ian-ross/pump-monitor/README.md

# pump-monitor
IoT system for pump shaft monitoring
