ian-ross/pump-monitor/doc/requirements.odt

Pump Monitor Requirements

# Components

## Enclosure

- Plastic sandwich box with locking cover
- Standard cable passthroughs with screw clamp and soft collet
- Silica gel dessicant
- Secure to pipe in shaft with jubilee clip, boltholes sealed with silicone gel

## Mains power input

- Short (30cm?) cable with mains plug to cable passthrough into enclosure.

## Power splitter

- Mains power input cable taken to standard junction box.

## Pump power outlet

- Water-resistant mains socket let into hole in enclosure, hole sealed with silicone gel.

## Pump power sensing

- Rogowski sense coil (Pulse PA3208NL) mounted inside junction box enclosing only live wire of connection to pump power.
- Pump power is 400 W, so 1.7 A RMS current when it’s on. The PA3208NL outputs 383 μV/A for 50 Hz input, i.e. about 650 μV.
- The Rogowski coil needs a data acquisition chip to go with it. Options are:
  - Analog Devices ADE7753 (€3.73, SPI interface, SSOP-20). Use this one, just because it has simpler interfacing – the ST Micro device has a very strange non-SPI serial interface.
  - ST Micro STPM01FTR (€2.40, weird non-SPI interface, TSSOP-20, has mode for current-only measurements).
- Another option is to implement a simple integrator and front-end amplifier with op-amps, then to use an ADC with an SPI interface (for the RPi) to sample the current signal.
- Question: what is the simplest way to do this? Using a dedicated di/dt current sense processing chip seems like the best idea, so go with the ADE7753.

## DC power supply

- Mains socket secured inside enclosure.
- Extension cable cut to give socket for this part and plug for 1.2.
- Encapsulated switching power supply plugged into socket.
- RPi power supply, and take 5V supply for other components from RPi headers.

## Processing

- Raspberry Pi 4.

## Ultrasonic sensor

- Something like one of the sensors from DFRobot.
- 5V supply.

## Pump control

- Pin the float switch of the pump on and use an SSR to start and stop the pump, i.e. control the pump directly from the monitor controller.
- Because the level monitoring needs to work correctly for the SSR approach to work, write software to run in two modes: “float mode” has the SSR permanently on, and uses the float switch on the pump to switch the pump on and off; “SSR mode” pins the float switch on and uses the SSR to switch the pump on and off, based on the water level measurements. For calibration of the level measurements for the SSR mode, the system can be run in float mode for a couple of months to collect data about water levels and when the pump switches on and off. That data can then be used to set up a control law for the SSR mode.

# Development steps

1. Test Wi-Fi transmission from within shaft (Arduino board in plastic box powered from USB supply threaded through hole in shaft cover). Done: doesn’t work, so use powerline network adapters. That means using something other than an Arduino: a Raspberry Pi has an Ethernet connection, so use the RPi 4 I have.
2. Breadboard pump power sense coil setup. (Even if you don’t use it, this is an interesting thing to do.) Done: couldn’t get it to work. Need to use a proper sense coil instead (a Rogowski coil, and associated circuitry).
3. Design carrier board:
  - power distribution;
  - connection to ultrasonic sensor;
  - power sense coil circuitry;
  - outputs suitable for driving an SSR.
4. Server software.
5. Initial installation: enclosure, power distribution, ultrasonic sensor, pump power sense coil, RPi, carrier board.
6. Actuator/pump control development (and if needed carrier board rev 2 or separate solenoid driver board).

# Software

## Arduino software

- Sample depth from ultrasonic sensor on regular timestep (1 Hz, statistics over 1 minute?)
- Current sense for pump supply on regular timestep (1 Hz, statistics over 1 minute?)
- Upload results to server on regular timestep (1 per minute?)

## Server software

- POST route for Arduino data upload (JSON with water depth and pump supply statistics and “twitched” flag)
- Pages to view saved data
- Alerts?
