ian-ross/pump-monitor/doc/box-layout.png

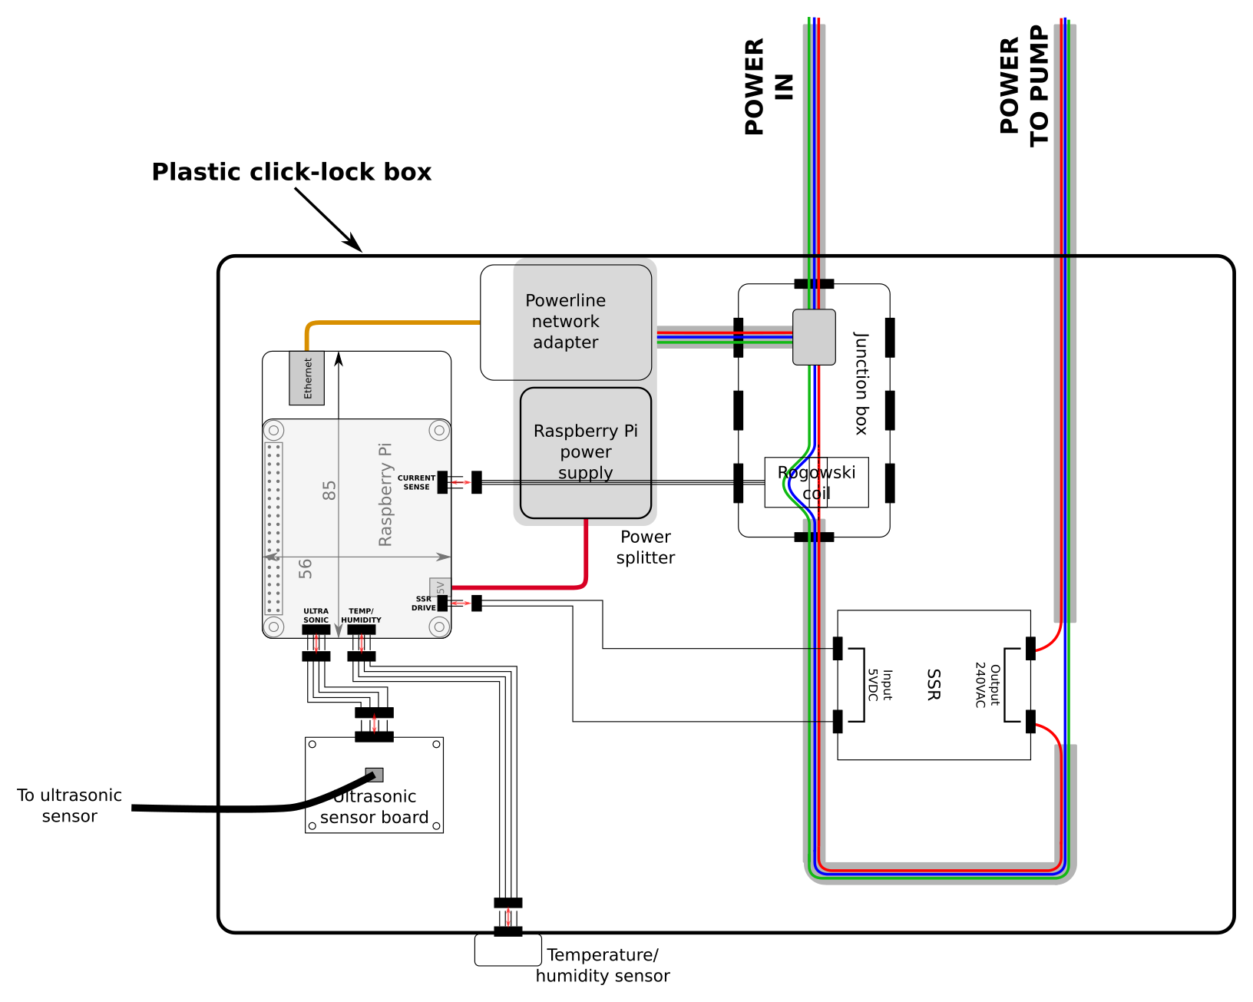
doc/box-layout.png
