ian-ross/pump-monitor/doc/system-diagram.png

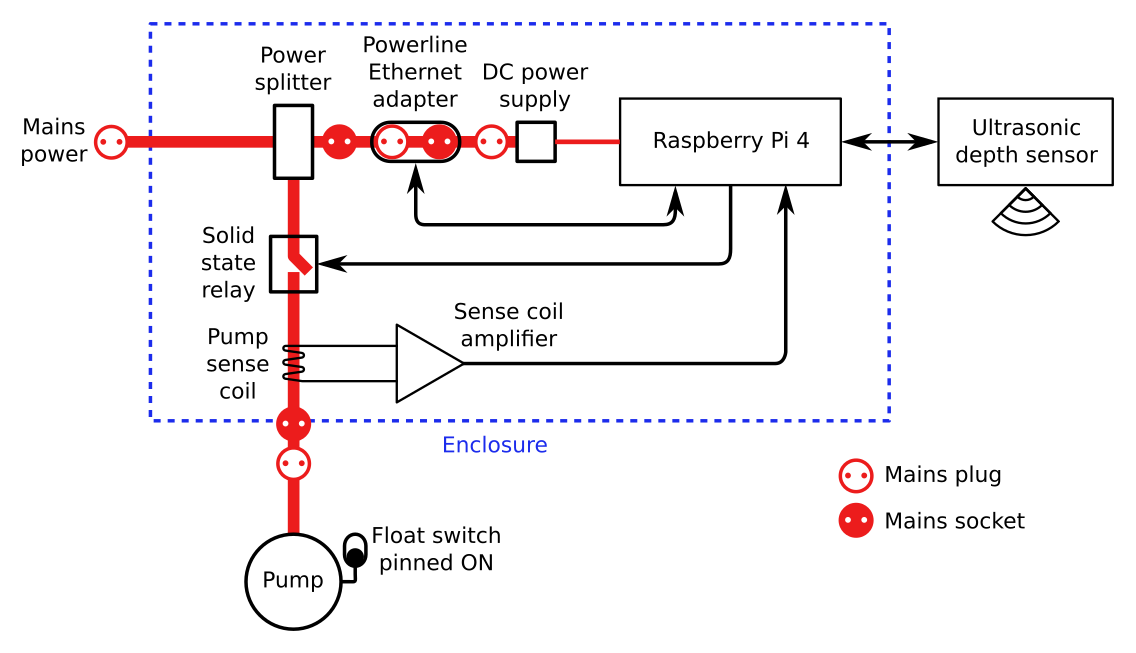
doc/system-diagram.png
