ian-ross/pump-monitor/pump-monitor-interface-board/pump-monitor-interface-board-bom.ods

Reference | Quantity | Value | MPN | In stock | Footprint | Datasheet | Link
J2 | 1 | RPI_HAT | SSQ-120-01-L-D | N | Connector_PinSocket_2.54mm:PinSocket_2x20_P2.54mm_Vertical | https://www.mouser.at/datasheet/2/527/ssq_th-1370157.pdf
J1 J3 | 2 | Conn_01x04 | TSW-104-25-T-S-RA | N | Connector_PinHeader_2.54mm:PinHeader_1x04_P2.54mm_Horizontal | https://www.mouser.at/datasheet/2/527/tsw_th-1345997.pdf
J4 | 1 | Conn_01x02 | TSW-102-25-T-S-RA | N | Connector_PinHeader_2.54mm:PinHeader_1x02_P2.54mm_Horizontal | https://www.mouser.at/datasheet/2/527/tsw_th-1345997.pdf
J5 | 1 | Conn_01x03 | TSW-103-25-F-S-RA | N | Connector_PinHeader_2.54mm:PinHeader_1x03_P2.54mm_Horizontal | https://www.mouser.at/datasheet/2/527/tsw_th-1345997.pdf
Q1 | 1 | 2N7002 | 2N7002ET7G | N | Package_TO_SOT_SMD:SOT-23 | https://www.mouser.at/datasheet/2/308/2N7002E_D-1571276.pdf | https://www.mouser.at/ProductDetail/ON-Semiconductor/2N7002ET7G?qs=l7cgNqFNU1iSXTOSQi2ecw%3D%3D
R11 | 1 | 6.8K | CRCW08056K80FKEA | N | Resistor_SMD:R_0805_2012Metric_Pad1.20x1.40mm_HandSolder | ~
R15 | 1 | 47K | CRCW080547K0FKEAC | N | Resistor_SMD:R_0805_2012Metric_Pad1.20x1.40mm_HandSolder | ~
R16 | 1 | 68K | CRCW080568K0FKEA | N | Resistor_SMD:R_0805_2012Metric_Pad1.20x1.40mm_HandSolder | ~
R20 R21 | 2 | 100K | CRCW0805100KFKEAC | N | Resistor_SMD:R_0805_2012Metric_Pad1.20x1.40mm_HandSolder | ~
R6 | 1 | 5K | CRCW08055K00FKTA | N | Resistor_SMD:R_0805_2012Metric_Pad1.20x1.40mm_HandSolder | ~
U3 | 1 | LMV321 | LMV321AIDBVR | N | Package_TO_SOT_SMD:SOT-23-5_HandSoldering | https://www.ti.com/lit/ds/symlink/lmv321a.pdf | https://www.ti.com/product/LMV321A
C1 C3 C6 | 3 | 1U | 885012107015 | Y | Capacitor_SMD:C_0805_2012Metric_Pad1.18x1.45mm_HandSolder
C2 C4 C5 C7 | 4 | 0.1U | 885012207098 | Y | Capacitor_SMD:C_0805_2012Metric_Pad1.18x1.45mm_HandSolder
D1 D2 | 2 | 1N914 | 1N914BW RH | Y | Diode_SMD:D_SOD-123F | https://www.mouser.at/datasheet/2/395/1N4148W_SERIES_K1804-1519318.pdf
R1 R13 | 2 | 12K | CRCW080512K0FKEA | Y | Resistor_SMD:R_0805_2012Metric_Pad1.20x1.40mm_HandSolder | ~
R4 R5 R8 R10 R12 | 5 | 10K | CRGP0805F10K | Y | Resistor_SMD:R_0805_2012Metric_Pad1.20x1.40mm_HandSolder | ~
R2 R14 R17 | 3 | 22K | CRCW080522K0FKEAC | Y | Resistor_SMD:R_0805_2012Metric_Pad1.20x1.40mm_HandSolder | ~
R3 R18 R19 | 3 | 1K | CRGP0805F1K0 | Y | Resistor_SMD:R_0805_2012Metric_Pad1.20x1.40mm_HandSolder | ~
R7 | 1 | 330K | CRCW0805330KFKEA | Y | Resistor_SMD:R_0805_2012Metric_Pad1.20x1.40mm_HandSolder | ~
R9 | 1 | 18K | CRGP0805F18K | Y | Resistor_SMD:R_0805_2012Metric_Pad1.20x1.40mm_HandSolder | ~
U1 | 1 | TLV4333 | TLV4333IDR | Y | Package_SO:SO-14_3.9x8.65mm_P1.27mm | https://www.ti.com/lit/ds/symlink/tlv4333.pdf | https://www.ti.com/product/TLV4333
U2 | 1 | LMV331 | LMV331IDBVR | Y | Package_TO_SOT_SMD:SOT-23-5_HandSoldering | http://www.ti.com/lit/ds/symlink/lmv331.pdf | https://www.ti.com/product/LMV331
