ian-ross/pump-monitor/doc/bom.ods

Component | Source | Part # | Qty | Description
Enclosure |  |  | 1 | Locking plastic box (size?)
Mains extension cable | Obi | 1831197 | 1 | 5m extension cable to cut for power input, socket for DC power supply, and cable from junction box to pump socket
Mains junction box | Obi | 8025538 | 1 | 40 mm x 56 mm x 23 mm, 4 connections
Waterproof mains socket | Obi | 7203417 | 1 | IP44 mains socket
Mains cable clamps | Obi |  | 3 | Standard 3-hole cable clamps
Cable passthroughs | Obi | 6057178 | 3? | 4.5-10 mm wire diameter
DC power supply |  |  | 1 | Raspberry Pi power supply
Raspberry Pi 4 |  |  | 1
Ultrasonic sensor | DFRobot? | SEN0313 | 1 | A01NYUB waterproof sensor (screw mounting)
Pump sense coil | n/a | n/a | 1-3 | Make from jumper wire, silicone gel and heat shrink tubing | <=== DOESN’T WORK. NEED TO RESEARCH.
Pump sense coil amplifier |  |  | 1-3
(Solid-state?) relay | Mouser |  | 1
Powerline Ethernet adapter | mylemon.at | TL-PA4010PKIT | 2 | TP-Link AV500+ Powerline Kit
