ian-ross/pump-monitor/pump-monitor-interface-board/pump-monitor-interface-board-schematic.pdf

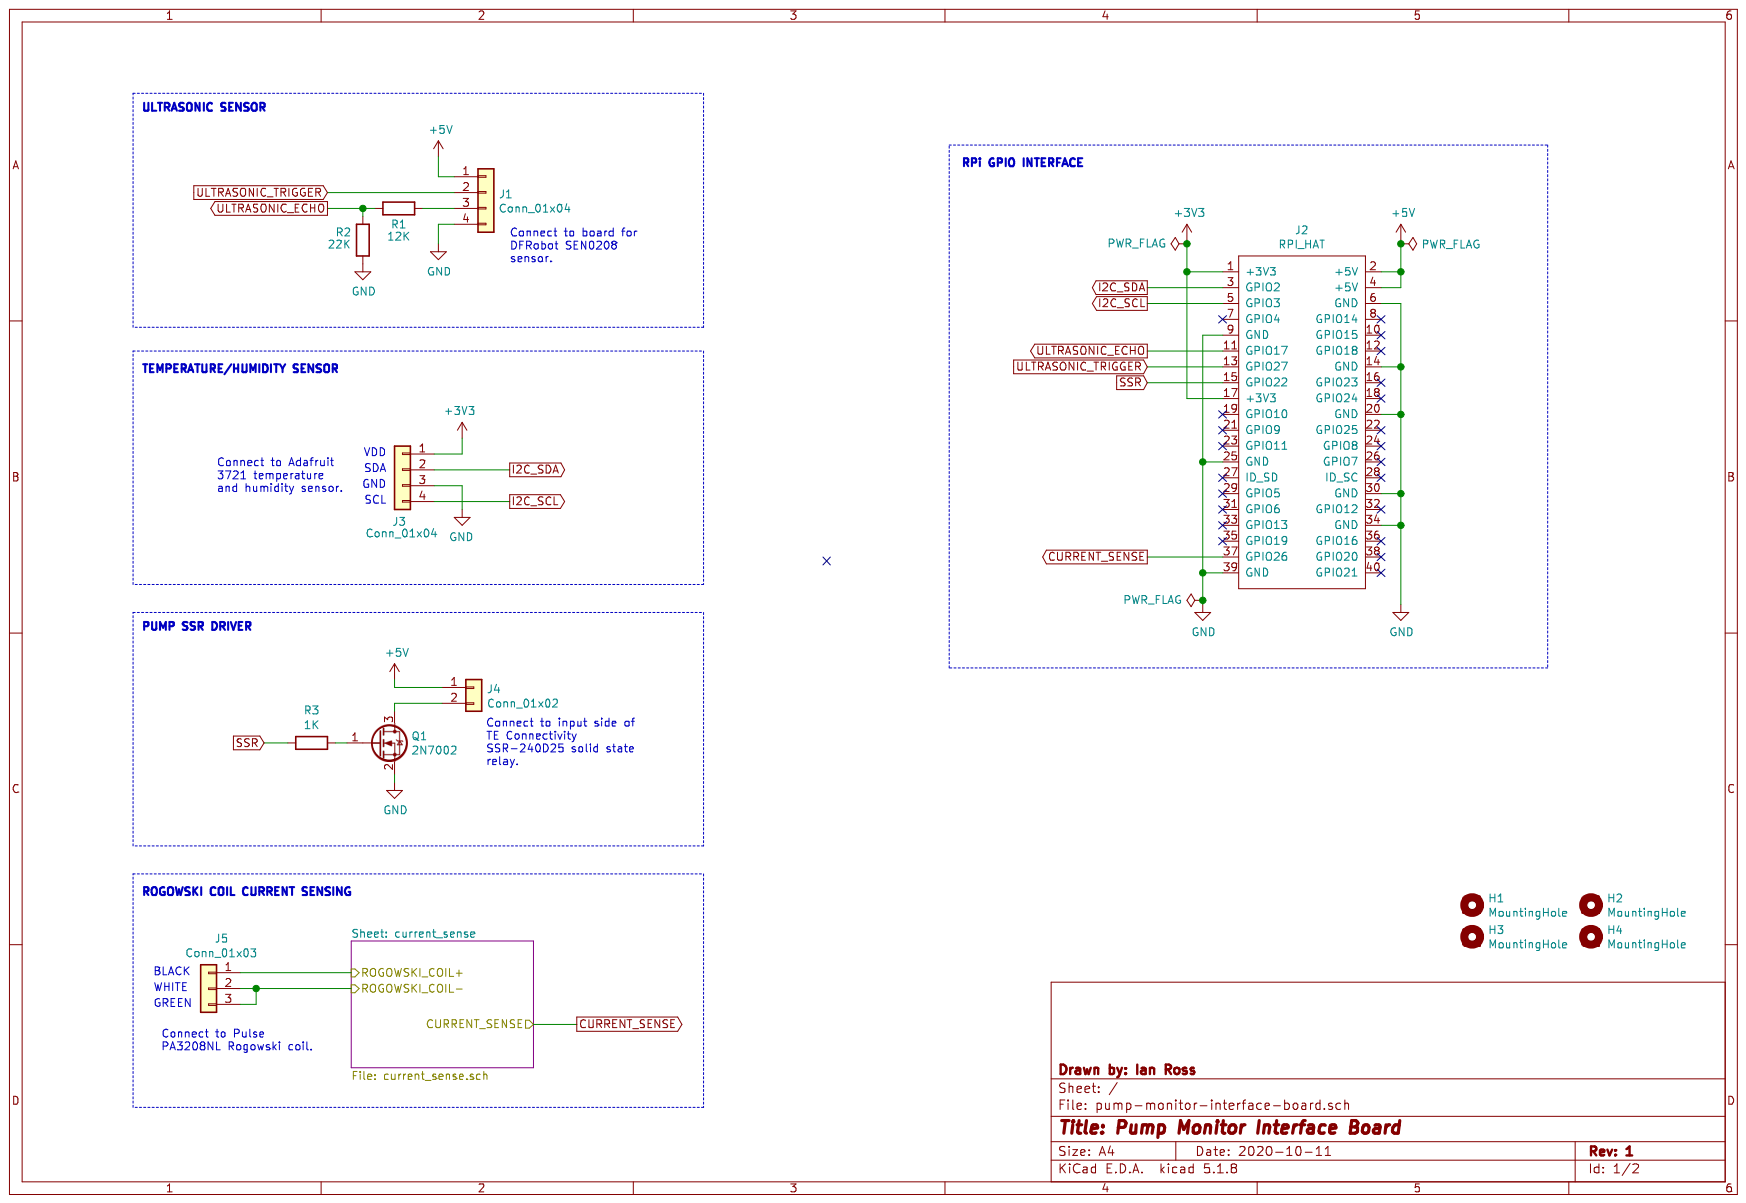
[picture p3: page 1]

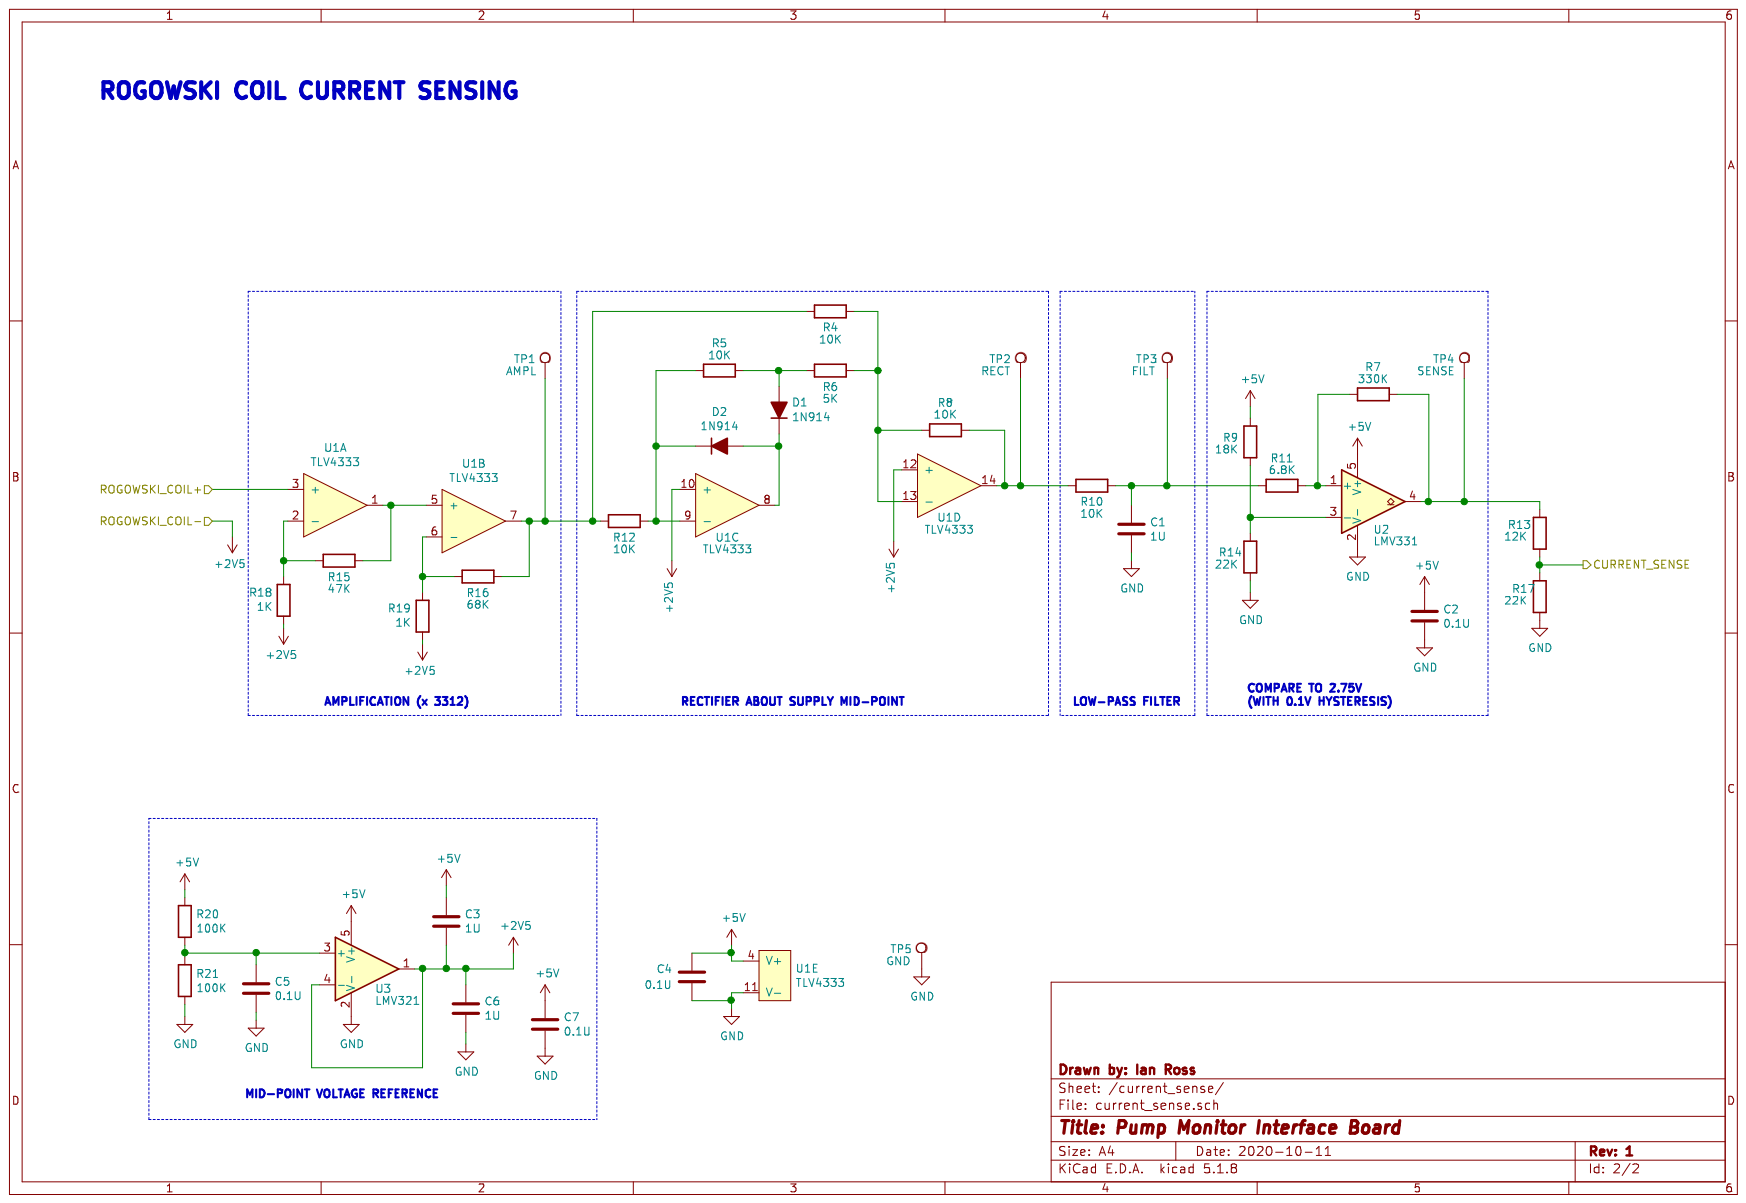
[picture p4: page 2]
