ian-ross/pump-monitor/experiments/rogowski-coil/rogowski-coil-1.asc

R1: res; 1K
R2: res; 50K
R3: res; 1K
R4: res; 50K
Rload: res; 10Meg
U3: AD8539
U4: AD8539
V1: voltage; 2.5
V2: voltage; -2.5
Vin: voltage; SINE(0 0.6M 50 1 0 0 250)
Named nets: +V, 0, OUT, IN, -V
.tran 0 10 0
