ian-ross/pump-monitor/experiments/rogowski-coil/rogowski-coil-2.asc

C1: cap; 0.1µ
C2: cap; 1µ
C3: cap; 1µ
C4: cap; 1µ
R1: res; 1K
R2: res; 50K
R3: res; 1K
R4: res; 50K
R5: res; 100K
R6: res; 100K
R7: res; 2K
R8: res; 3K
Rload: res; 100K
U1: AD8538
U2: LT1720
U3: AD8539
U4: AD8539
V3: voltage; 5
Vin: voltage; SINE(0 0.6M 50 0.1 0 0 100)
Named nets: OUT, IN, +V, 0, Vmid
.tran 0 2.5 0
