ian-ross/pump-monitor/experiments/rogowski-coil/rogowski-coil-3.asc

C1: cap; 0.1µ
C2: cap; 1µ
C3: cap; 1µ
C4: cap; 1µ
D1: diode
D2: diode
R1: res; 1K
R2: res; 47K
R3: res; 1K
R4: res; 68K
R5: res; 100K
R6: res; 100K
R7: res; 18K
R8: res; 22K
R9: res; 10K
R10: res; 10K
R11: res; 5K
R12: res; 10K
R13: res; 10K
R14: res; 10K
R15: res; 6.8K
R16: res; 330K
U1: AD8538
U2: LT1720
U3: AD8539
U4: AD8539
U5: AD8539
U6: AD8539
V3: voltage; 5
Vin: voltage; SINE(0 0.6M 50 0.1 0 0 50)
Named nets: OUT, IN, +V, 0, Vmid
.tran 0 1.5 0
SPLIT SUPPLY
AMPLIFICATION (x 3312)
RECTIFIER ABOUT SUPPLY MID-POINT
COMPARE TO 2.75V
(WITH 0.1V HYSTERESIS)
SOURCE: 600 MICRO-VOLT @ 50 Hz
LOW-PASS FILTER
