ian-ross/pump-monitor/experiments/rogowski-coil/rogowski-coil-5.asc

C1: cap; 0.1µ
C2: cap; 1µ
C3: cap; 1µ
C4: cap; 1µ
D1: schottky; 1N5817
R1: res; 1K
R2: res; 50K
R3: res; 1K
R4: res; 50K
R5: res; 100K
R6: res; 100K
Rload: res; 10K
U1: AD8538
U3: AD8539
U4: AD8539
V3: voltage; 5
Vin: voltage; SINE(0 0.6M 50 0.1 0 0 100)
Named nets: OUT, IN, +V, 0, Vmid
.tran 0 2.5 0
