ian-ross/pump-monitor/experiments/rogowski-coil/rogowski-coil-6.asc

C4: cap; 4.7µ
D1: diode
D2: diode
R1: res; 1K
R2: res; 47K
R3: res; 1K
R4: res; 68K
R5: res; 120K
R6: res; 18K
R7: res; 1K
R8: res; 20K
R9: res; 22K
U1: LT1720
U2: AD8539
U3: AD8539
U4: AD8539
U5: AD8539
V1: voltage; 2.5
V3: voltage; 5
Vin: voltage; SINE(0 0.6M 50 0.1 0 0 50)
Named nets: OUT, IN, +V, 0, Vmid
.tran 0 1.5 0
SPLIT SUPPLY
AMPLIFICATION (x 3876)
SOURCE: 600 MICRO-VOLT @ 50 Hz
PEAK DETECTOR WITH DECAY
COMPARE WITH 2.75V
