ian-ross/pump-monitor/pump-monitor-interface-board/pump-monitor-interface-board.kicad_pcb

## KiCad design pump-monitor-interface-board/pump-monitor-interface-board.kicad_pcb (2020-12-14)

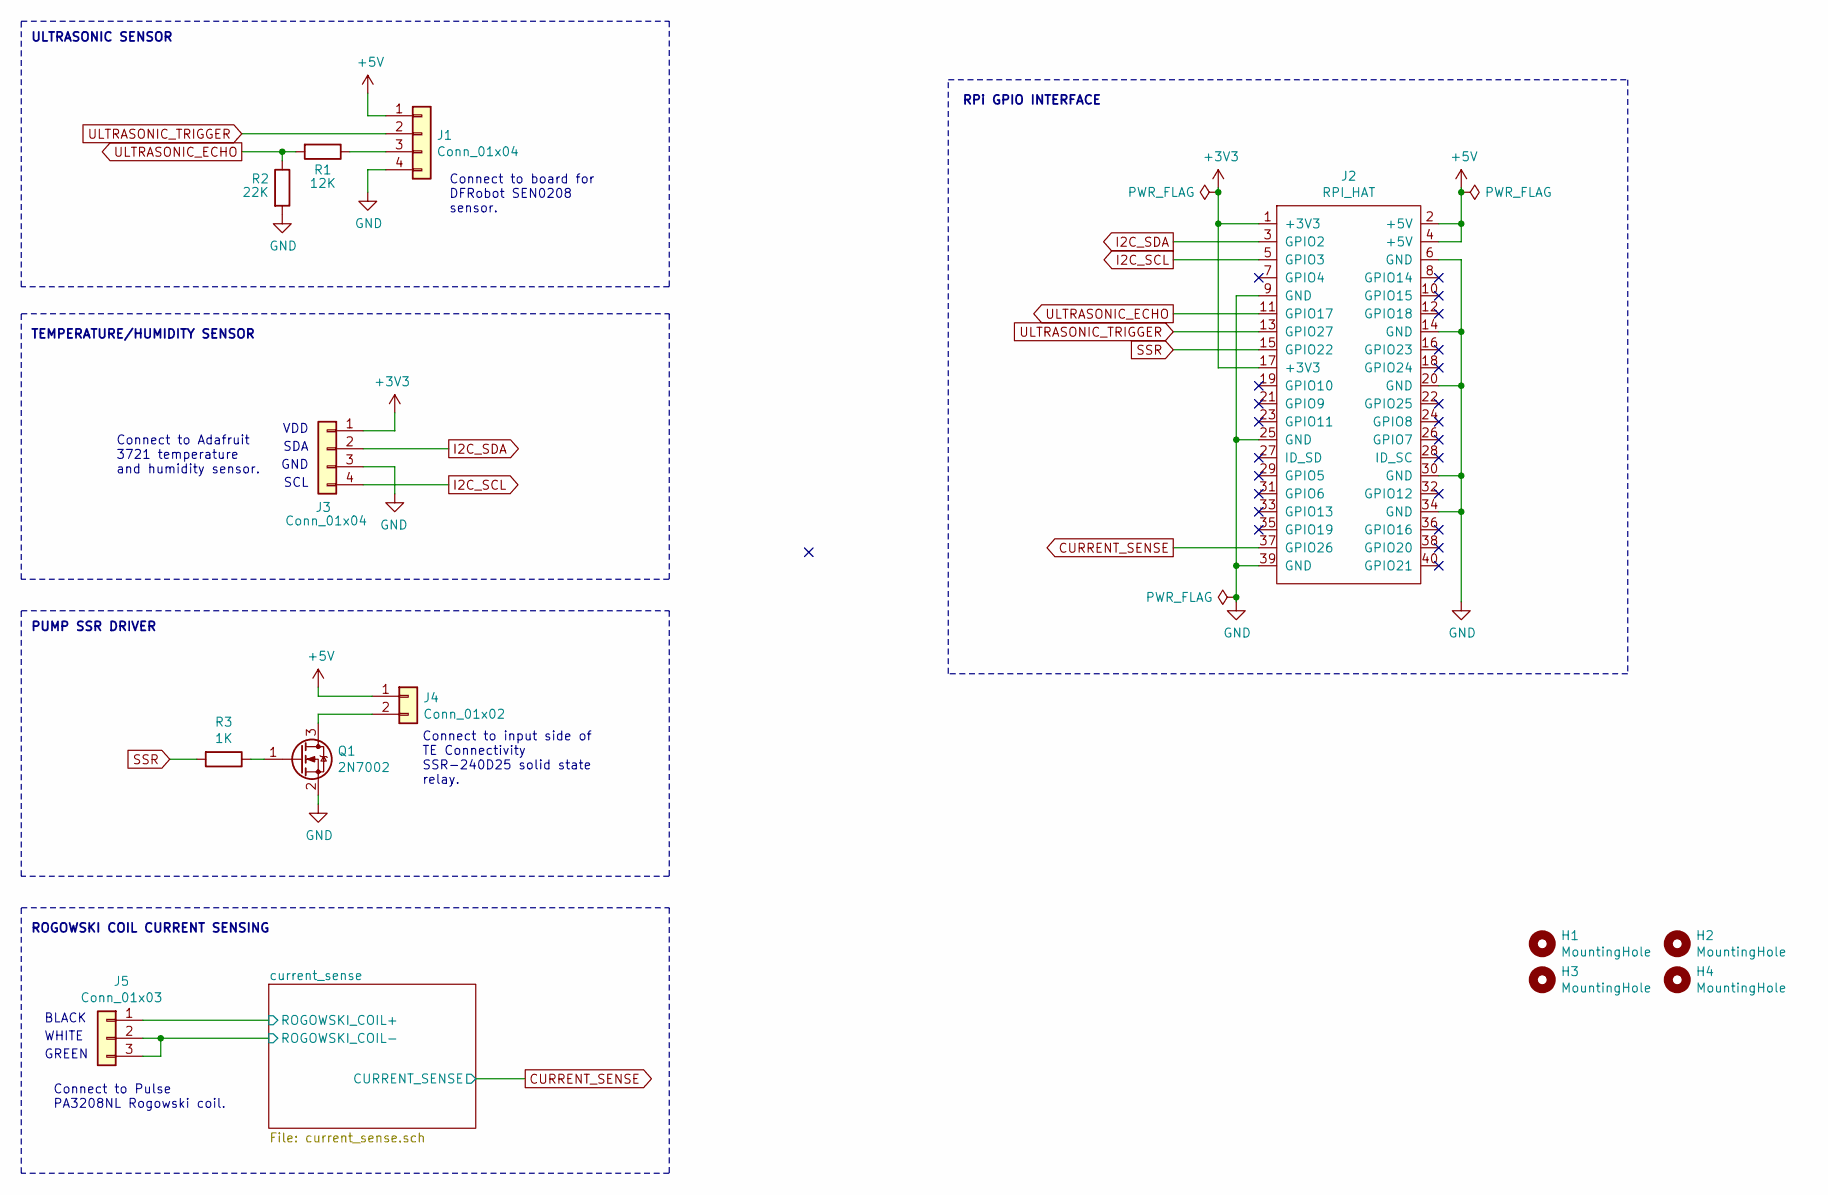
[picture p5: schematic pump-monitor-interface-board.sch, Pump Monitor Interface Board]

Parts:
H1, H2, H3, H4: MountingHole; MountingHole_2.7mm_M2.5; MPN n/a
J1, J3: Conn_01x04; PinHeader_1x04_P2.54mm_Horizontal; MPN TSW-104-25-T-S-RA
J2: RPI_HAT; PinSocket_2x20_P2.54mm_Vertical; MPN SSQ-120-01-L-D
J4: Conn_01x02; PinHeader_1x02_P2.54mm_Horizontal; MPN TSW-102-25-T-S-RA
J5: Conn_01x03; PinHeader_1x03_P2.54mm_Horizontal; MPN TSW-103-25-F-S-RA
Q1: 2N7002; SOT-23; MPN 2N7002ET7G
R1: 12K; R_0805_2012Metric_Pad1.20x1.40mm_HandSolder; MPN CRCW080512K0FKEA
R2: 22K; R_0805_2012Metric_Pad1.20x1.40mm_HandSolder; MPN CRCW080522K0FKEAC
R3: 1K; R_0805_2012Metric_Pad1.20x1.40mm_HandSolder; MPN CRGP0805F1K0

Connections:
+2V5: J5.2, J5.3; also elsewhere on the board
+3V3: J2.1 (+3V3), J2.17 (+3V3), J3.1
+5V: J1.1, J2.2 (+5V), J2.4 (+5V), J4.1; also elsewhere on the board
/current_sense/ROGOWSKI_COIL+: J5.1; also elsewhere on the board
CURRENT_SENSE: J2.37 (GPIO26); also elsewhere on the board
GND: J1.4, J2.6 (GND), J2.9 (GND), J2.14 (GND), J2.20 (GND), J2.25 (GND), J2.30 (GND), J2.34 (GND), J2.39 (GND), J3.3, Q1.2 (S), R2.2; also elsewhere on the board
I2C_SCL: J2.5 (GPIO3), J3.4
I2C_SDA: J2.3 (GPIO2), J3.2
unnamed: J1.3, R1.1
unnamed: J4.2, Q1.3 (D)
unnamed: Q1.1 (G), R3.1
SSR: J2.15 (GPIO22), R3.2
ULTRASONIC_ECHO: J2.11 (GPIO17), R1.2, R2.1
ULTRASONIC_TRIGGER: J1.2, J2.13 (GPIO27)

Notes on the sheet:
Connect to Pulse PA3208NL Rogowski coil.
RPi GPIO INTERFACE
BLACK
WHITE
GREEN
ROGOWSKI COIL CURRENT SENSING
PUMP SSR DRIVER
TEMPERATURE/HUMIDITY SENSOR
ULTRASONIC SENSOR
VDD
SDA
GND
SCL
Connect to Adafruit 3721 temperature and humidity sensor.
Connect to input side of TE Connectivity SSR-240D25 solid state relay.
Connect to board for DFRobot SEN0208 sensor.

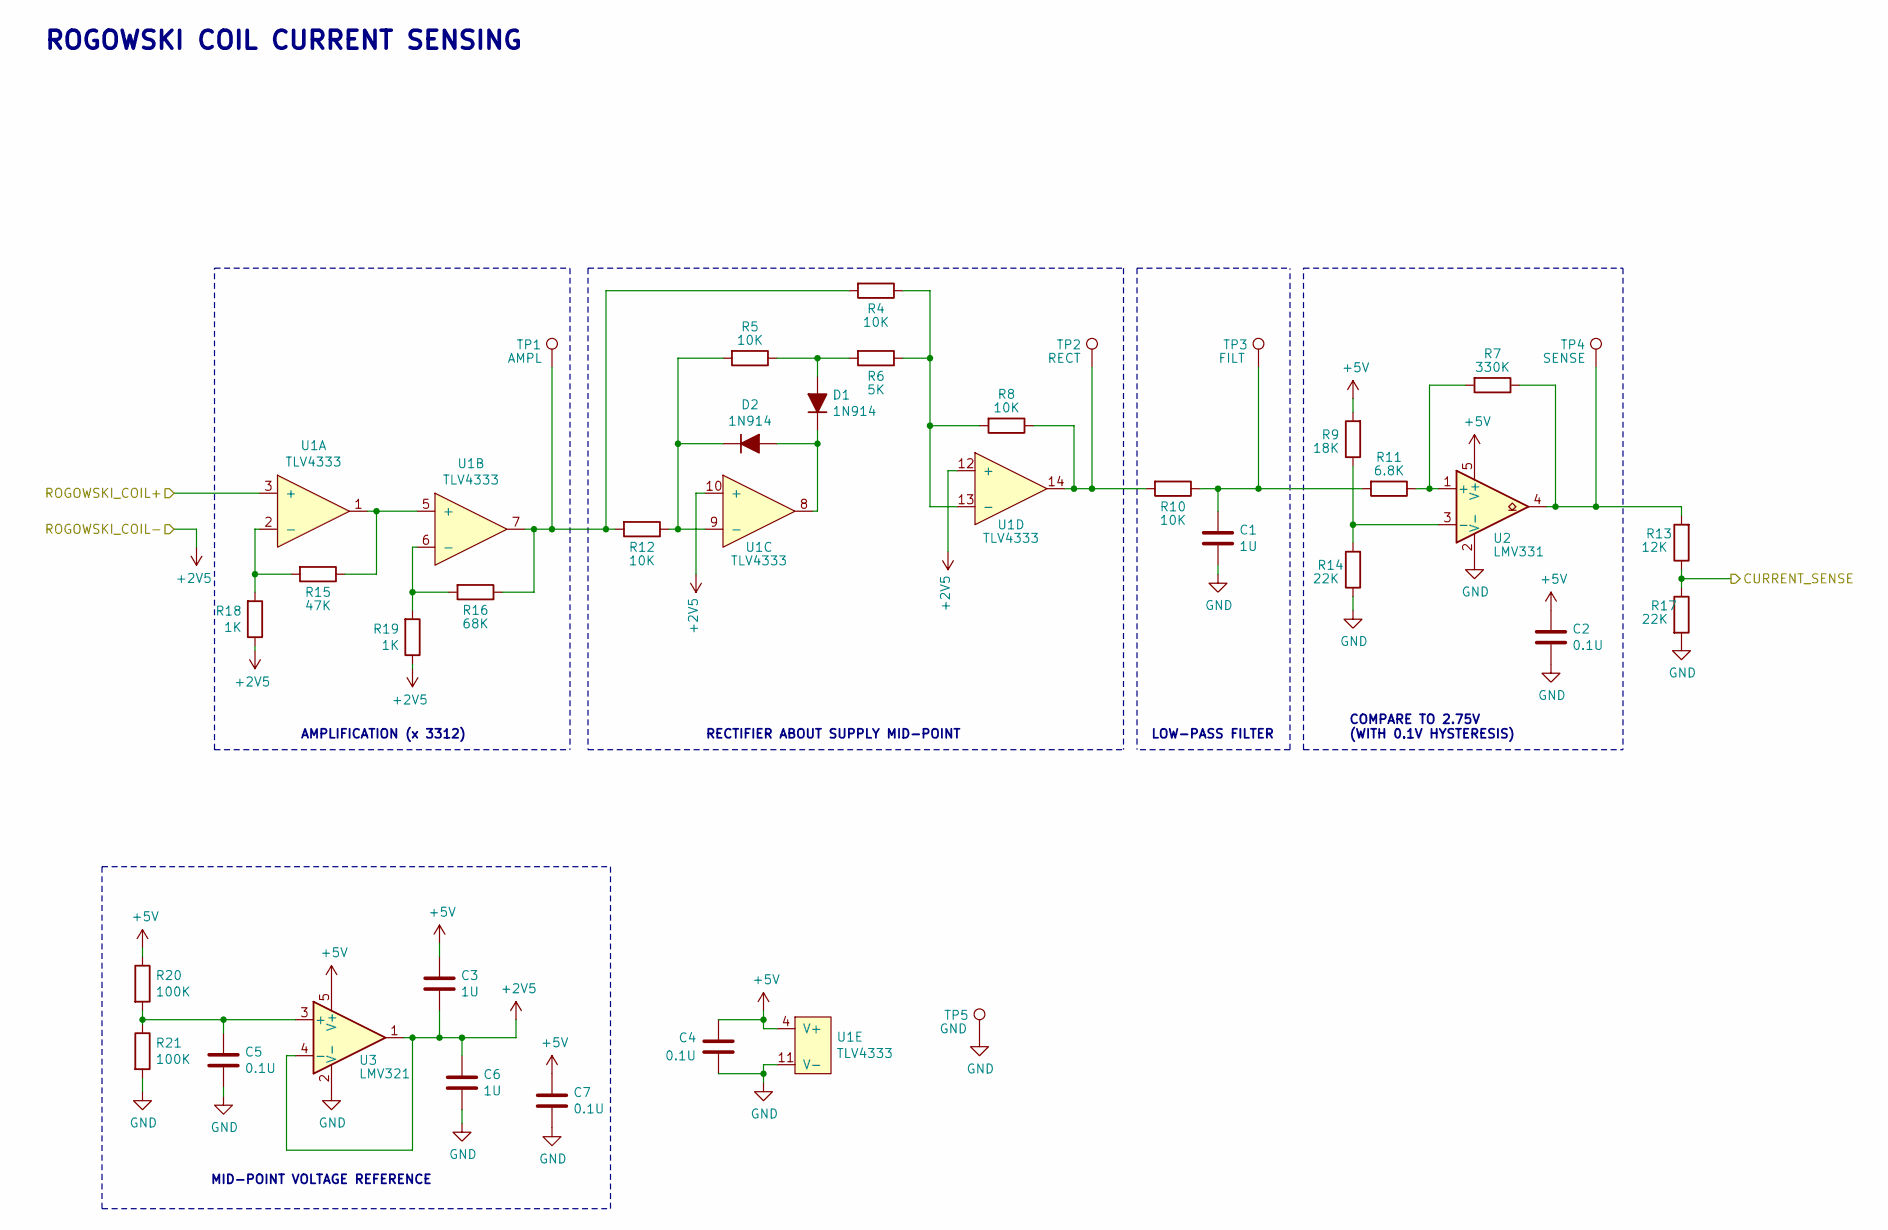
[picture p6: schematic current_sense.sch]

Parts:
C1, C3, C6: 1U; C_0805_2012Metric_Pad1.18x1.45mm_HandSolder; MPN 885012107015
C2, C4, C5, C7: 0.1U; C_0805_2012Metric_Pad1.18x1.45mm_HandSolder; MPN 885012207098
D1, D2: 1N914; D_SOD-123F; MPN 1N914BW RH
R4, R5, R8, R10, R12: 10K; R_0805_2012Metric_Pad1.20x1.40mm_HandSolder; MPN CRGP0805F10K
R6: 5K; R_0805_2012Metric_Pad1.20x1.40mm_HandSolder; MPN CRCW08055K00FKTA
R7: 330K; R_0805_2012Metric_Pad1.20x1.40mm_HandSolder; MPN CRCW0805330KFKEA
R9: 18K; R_0805_2012Metric_Pad1.20x1.40mm_HandSolder; MPN CRGP0805F18K
R11: 6.8K; R_0805_2012Metric_Pad1.20x1.40mm_HandSolder; MPN CRCW08056K80FKEA
R13: 12K; R_0805_2012Metric_Pad1.20x1.40mm_HandSolder; MPN CRCW080512K0FKEA
R14, R17: 22K; R_0805_2012Metric_Pad1.20x1.40mm_HandSolder; MPN CRCW080522K0FKEAC
R15: 47K; R_0805_2012Metric_Pad1.20x1.40mm_HandSolder; MPN CRCW080547K0FKEAC
R16: 68K; R_0805_2012Metric_Pad1.20x1.40mm_HandSolder; MPN CRCW080568K0FKEA
R18, R19: 1K; R_0805_2012Metric_Pad1.20x1.40mm_HandSolder; MPN CRGP0805F1K0
R20, R21: 100K; R_0805_2012Metric_Pad1.20x1.40mm_HandSolder; MPN CRCW0805100KFKEAC
TP1: AMPL; TestPoint_Keystone_5000-5004_Miniature; MPN n/a
TP2: RECT; TestPoint_Keystone_5000-5004_Miniature; MPN n/a
TP3: FILT; TestPoint_Keystone_5000-5004_Miniature; MPN n/a
TP4: SENSE; TestPoint_Keystone_5000-5004_Miniature; MPN n/a
TP5: GND; TestPoint_Keystone_5000-5004_Miniature; MPN n/a
U1: TLV4333; SO-14_3.9x8.65mm_P1.27mm; MPN TLV4333IDR
U2: LMV331; SOT-23-5_HandSoldering; MPN LMV331IDBVR
U3: LMV321; SOT-23-5_HandSoldering; MPN LMV321AIDBVR

Connections:
+2V5: C3.2, C6.1, R18.1, R19.1, U1.10 (+), U1.12 (+), U3.1, U3.4 (-); also elsewhere on the board
+5V: C2.1, C3.1, C4.1, C7.1, R9.2, R20.1, U1.4 (V+), U2.5 (V+), U3.5 (V+); also elsewhere on the board
/current_sense/ROGOWSKI_COIL+: U1.3 (+); also elsewhere on the board
CURRENT_SENSE: R13.1, R17.1; also elsewhere on the board
GND: C1.2, C2.2, C4.2, C5.2, C6.2, C7.2, R14.1, R17.2, R21.2, TP5.1, U1.11 (V-), U2.2 (V-), U3.2 (V-); also elsewhere on the board
unnamed: C1.1, R10.1, R11.2, TP3.1
unnamed: C5.1, R20.2, R21.1, U3.3 (+)
unnamed: D1.1 (K), D2.2 (A), U1.8
unnamed: D1.2 (A), R5.1, R6.2
unnamed: D2.1 (K), R5.2, R12.1, U1.9 (-)
unnamed: R4.1, R6.1, R8.2, U1.13 (-)
unnamed: R8.1, R10.2, TP2.1, U1.14
unnamed: R7.2, R11.1, U2.1 (+)
unnamed: R4.2, R12.2, R16.1, TP1.1, U1.7
unnamed: R7.1, R13.2, TP4.1, U2.4
unnamed: R9.1, R14.2, U2.3 (-)
unnamed: R15.1, U1.1, U1.5 (+)
unnamed: R15.2, R18.2, U1.2 (-)
unnamed: R16.2, R19.2, U1.6 (-)

Notes on the sheet:
AMPLIFICATION (x 3312)
RECTIFIER ABOUT SUPPLY MID-POINT
LOW-PASS FILTER
COMPARE TO 2.75V (WITH 0.1V HYSTERESIS)
ROGOWSKI COIL CURRENT SENSING
MID-POINT VOLTAGE REFERENCE

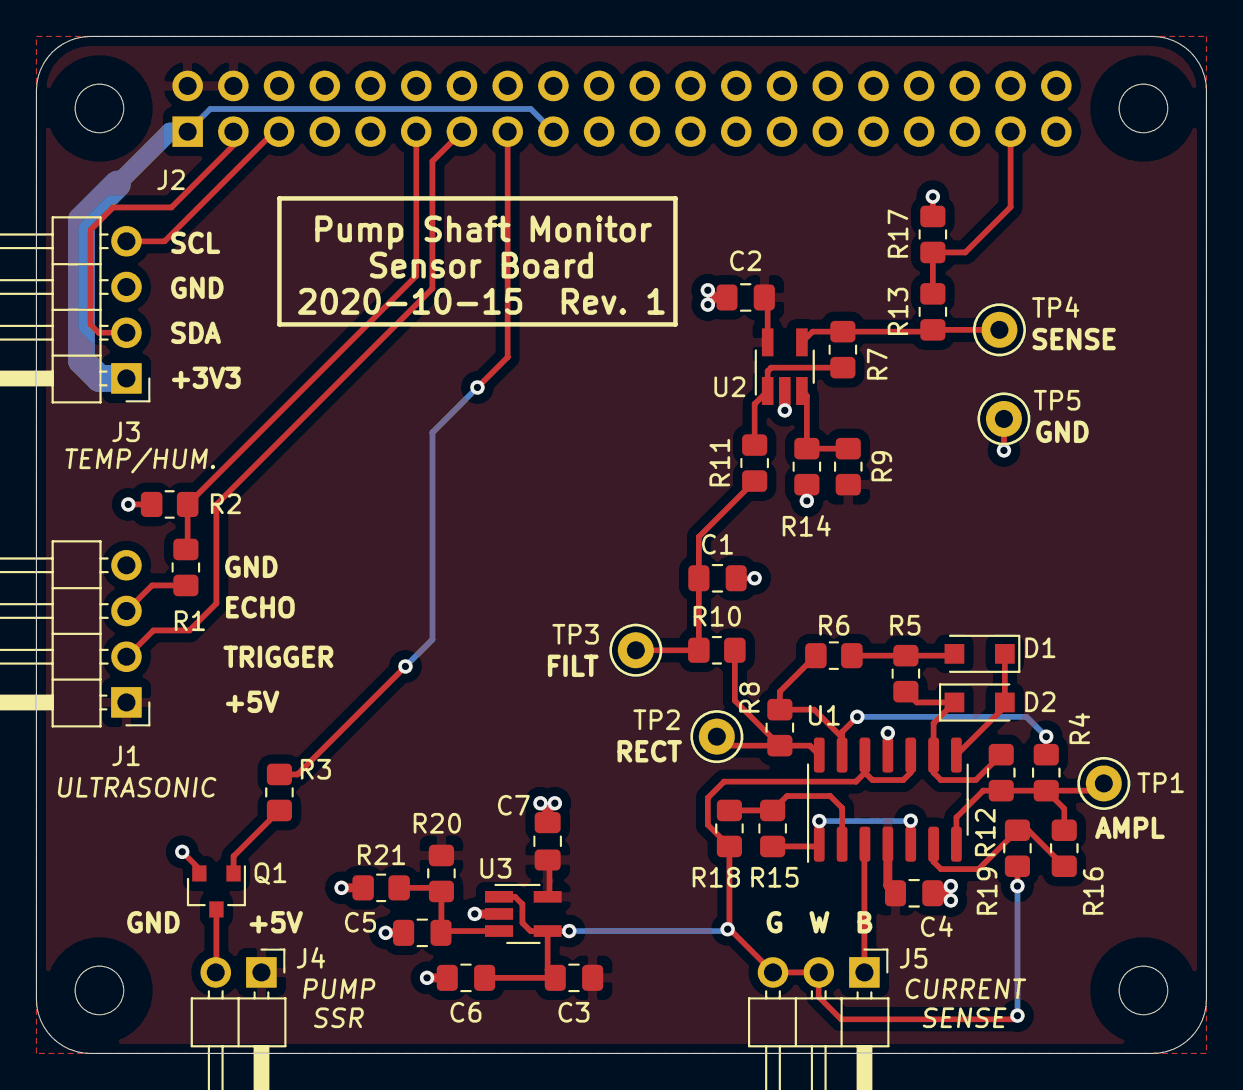
[picture p7: board pump-monitor-interface-board.kicad_pcb from above]

Board: 2 copper layers, 65.0 x 56.5 mm, 48 parts (1 on the bottom side), 28 nets.
