ian-ross/pump-monitor/(commit log)

2020-10-15 Interface board layout done
    [bom.ods, current_sense.sch, pump-monitor-interface-board.kicad_pcb, pump-monitor-interface-board.sch, ssr_driver.sch, temp_sensor.sch, ultrasonic_sensor.sch]
2020-10-22 Design checklists
    [current_sense.sch, pump-monitor-interface-board.kicad_pcb]
2020-12-14 Add ultrasonic sensor driver as submodule
2020-12-14 PDF schematic of interface board
